BRshreya29/High-Accuracy-Current-Source-for-HVAC-Analog-Control-Applications/ltspice/plots/22_percent_duty_cycle_to_current_precision_output.png

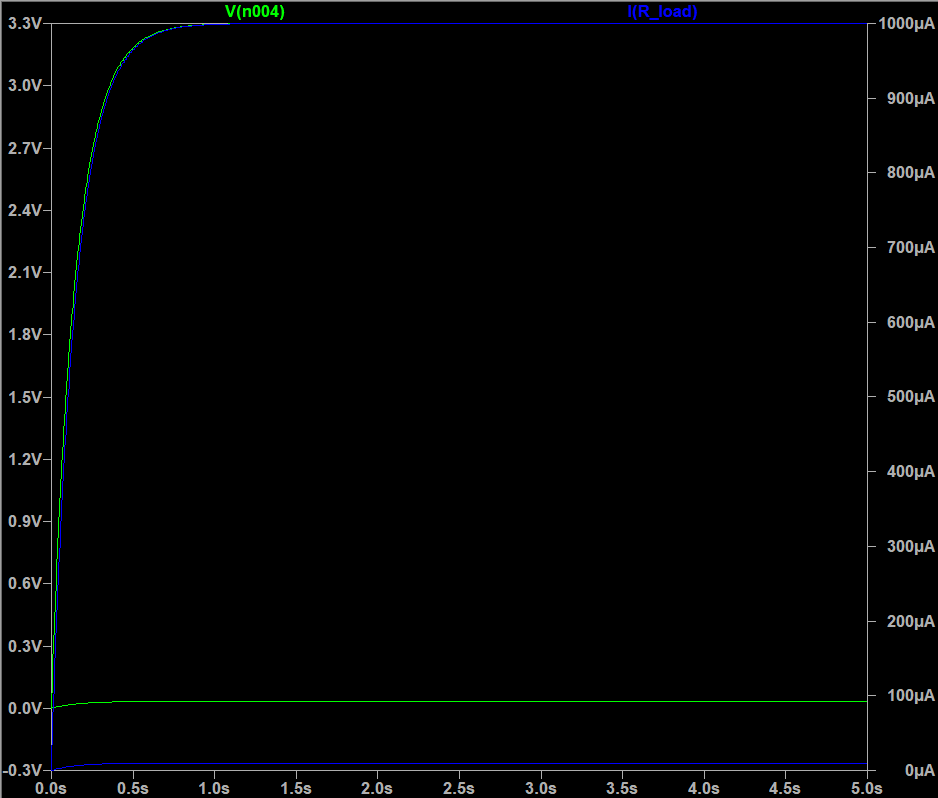
ltspice/plots/22_percent_duty_cycle_to_current_precision_output.png
