BRshreya29/High-Accuracy-Current-Source-for-HVAC-Analog-Control-Applications/ltspice/plots/comparator_0-1mA_output.png

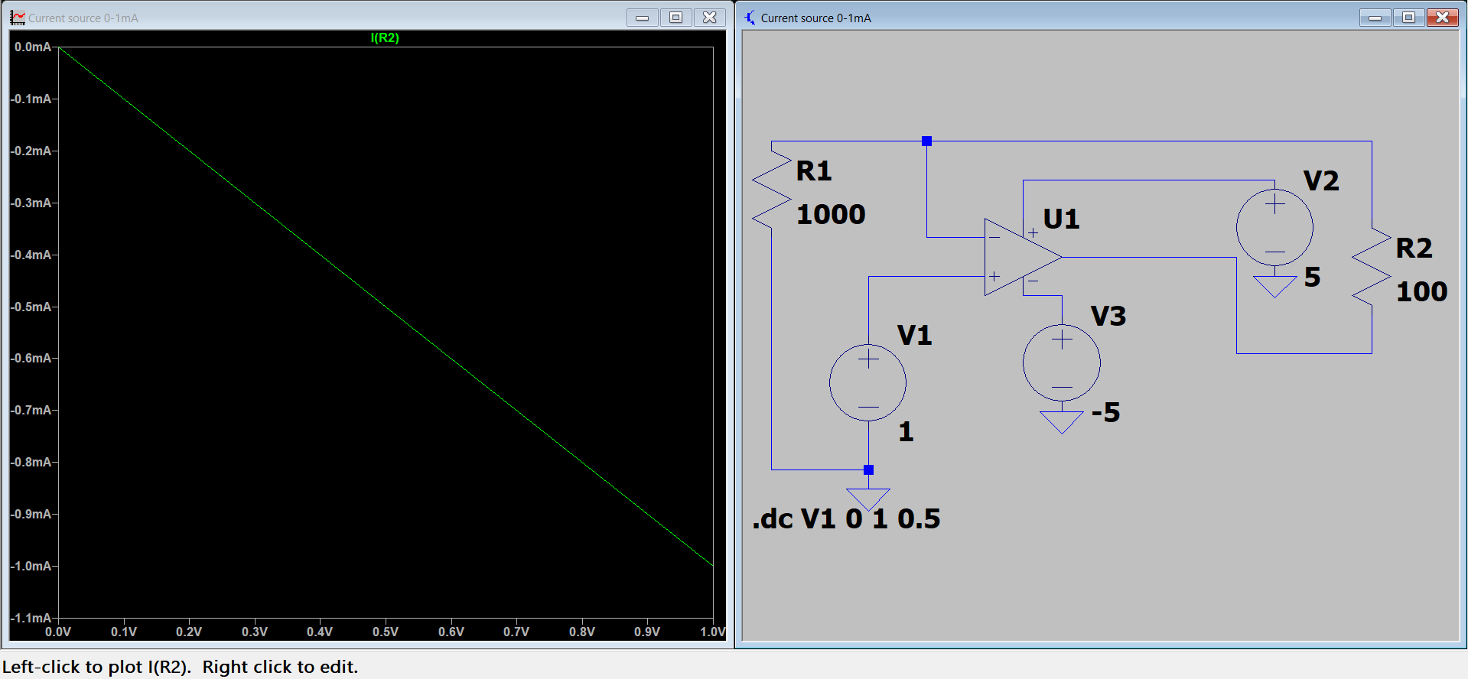
ltspice/plots/comparator_0-1mA_output.png
