BRshreya29/High-Accuracy-Current-Source-for-HVAC-Analog-Control-Applications/ltspice/plots/monte_carlo_analysis.png

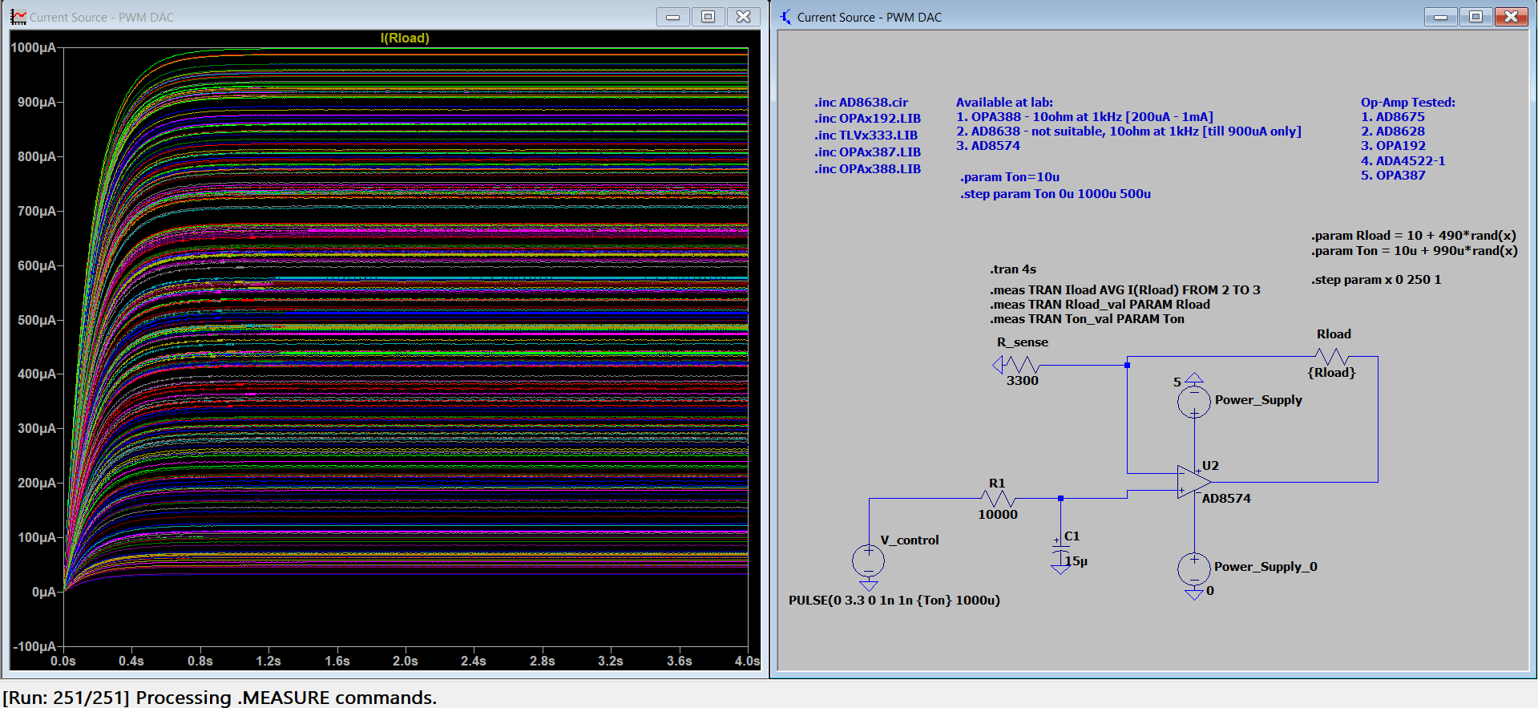
ltspice/plots/monte_carlo_analysis.png
