BRshreya29/High-Accuracy-Current-Source-for-HVAC-Analog-Control-Applications/ltspice/Final_design.asc

C1: polcap; {wc(15µ,tolc,2)}; V=4 Irms=560m Rser=0.2 Lser=0
Power_Supply: voltage; 5
Power_Supply_0: voltage; 0
R1: res; {wc(10000,tolr,1)} tc=0.0001; tol=1
R_sense: res; {wc(3300,tolrsense,0)} tc=0.0001; tol=0.1
Rload: res; 500
U2: AD8574
V_control: voltage; PULSE(0 3.3 0 1n 1n 1000u 1000u)
Named nets: 0
.tran 4s
.param tolr 0.01
.param tolrsense 0.001
.param tolc 0.15
.param numruns 8
.step param run 0 7 1
.meas TRAN V_rload AVG V(N002) - V(N001) FROM 3 TO 4
.meas TRAN Iload AVG I(Rload) FROM 3 TO 4
.meas TRAN R_load_calc PARAM V_rload / Iload
.meas TRAN V_rsense AVG V(n001) FROM 3 TO 4
.meas TRAN I_rsense AVG I(R_sense) FROM 3 TO 4
.meas TRAN R_sense_calc PARAM V_rsense / I_rsense
.temp -40 27 85
.func wc(nom,tol,index) if(run==numruns,nom,if(binary(run,index),nom*(1+tol),nom*(1-tol)))
.func binary(run,index) floor(run/(2**index))-2*floor(run/(2**(index+1)))
Constant Current Source across Rload
Use:
1. wc for Worst Case analysis
2. mc for Monte Carlo analysis
Commands for Measurements:
