BRshreya29/High-Accuracy-Current-Source-for-HVAC-Analog-Control-Applications/ltspice/Testing_stage_file.asc

C1: polcap; 15µ; V=4 Irms=560m Rser=0.2 Lser=0 mfg="Vishay" pn="T55P156M004" type="Tantalum Polymer"
C2: cap; 0.1µ
C3: cap; 2.2µ
Power_Supply: voltage; 5
Power_Supply_0: voltage; 0
R1: res; 10000; tol=5
R2: res; 1k
R3: res; 1k
R4: res; 10k
R_load: res; 500; tol=5
R_sense: res; 3300; tol=1
U1: AD8574
U3: MAX6070_33
U4: AD8031
V1: voltage; 5
V_control: voltage; PULSE(0 1.8 0 5n 5n 1000u 1000u)
Named nets: 0
.tran 3s
.param Ton=10u
.step param Ton 10u 100u 10u
.step param run 0 1 1
Op-Amp Tested:
1. AD8675
2. AD8628
3. OPA192
4. ADA4522-1
5. OPA387
6. MAX4230
7. AD8040
8. OPA4342
.inc OPAx387.LIB
.inc OPAx192.LIB
.func wc(nom,tol,index) if(run==numruns,nom,if(binary(run,index),nom*(1+tol),nom*(1-tol)))
.func binary(run,index) floor(run/(2**index))-2*floor(run/(2**(index+1)))
.param tola 0.05
.meas TRAN V_rsense AVG V(n003) FROM 3 TO 4
.meas TRAN I_rsense AVG I(R_sense) FROM 3 TO 4
.meas TRAN R_sense_calc PARAM V_rsense / I_rsense
.meas TRAN V_rload AVG V(N004) - V(N003) FROM 3 TO 4
.meas TRAN Iload AVG I(R_load) FROM 3 TO 4
.meas TRAN R_load_calc PARAM V_rload / Iload
 
.meas TRAN V_dc AVG V(n007) FROM 3 TO 4
.measure TRAN PulseWidth WHEN V(n010) > 2 RISE=1 FALL=1
.measure TRAN PulseWidthvref WHEN V(n009) > 2 RISE=1 FALL=1
