BRshreya29/High-Accuracy-Current-Source-for-HVAC-Analog-Control-Applications/ltspice/core_comparator_stage.asc

R1: res; 1000
R2: res; 100
U1: UniversalOpAmp
V1: voltage; 1
V2: voltage; 5
V3: voltage; -5
Named nets: 0
.dc V1 0 1 0.5
