BRshreya29/High-Accuracy-Current-Source-for-HVAC-Analog-Control-Applications/test_results/Final_circuit_testing_measurements.xlsx

Sheet: esp
ESP Input |  | DSO Measurements of Input |  |  |  |  | DSO Measurements after V_ref IC |  |  |  |  |  |  | Output |  | Error
 |  |  | Node 1 |  |  |  |  | Node 2 |  |  | Vdc Measurements |  |  | Node 3 | Node 4 | Absoulte Error | Percentage Error | Absoulte Error | Percentage Error
DutyCycle_Input(%) | CH1_Amplitude(V) | CH1_Freq(Hz) | CH1_PosWidth(µs) | CH1_Period(µs) | CH1_DutyCycle(%) | CH1_Amplitude(V) | CH1_Freq(Hz) | CH1_PosWidth(s) | CH1_Period(s) | CH1_DutyCycle(%) | VDC_expected (V) | Vdc_error | Vdc_expected for 3.24 V | VDC_DMM(V) | IDC_DMM(µA) | Idc (µA) | Idc | Vdc (A) | Vdc
1 | 3.68 | 1000.21 | 10.64 | 999.79 | 1.06 | 3.43 | 1000.17 | 10.71 | 999.83 | 1.07 | 0.03 | 0.01 | 0.03242 | 0.043663 | 13.26 | 2.55 | 19.23 | 0.011 | 32.31
2 | 3.58 | 1000.25 | 20.73 | 999.75 | 2.07 | 3.43 | 1000.26 | 20.77 | 999.74 | 2.08 | 0.07 | 0.01 | 0.06482 | 0.076517 | 23.22 | 2.45 | 10.56 | 0.011 | 15.93
3 | 3.90 | 1000.21 | 30.82 | 999.79 | 3.08 | 3.43 | 1000.19 | 30.68 | 999.81 | 3.07 | 0.10 | 0.01 | 0.09722 | 0.109430 | 33.20 | 2.53 | 7.61 | 0.010 | 10.54
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
