BRshreya29/High-Accuracy-Current-Source-for-HVAC-Analog-Control-Applications/test_results/Monte-Carlo_Analysis.xlsx

Sheet: Step 4
Step Number | Ton | R_load | I_load (A) | I_load (µA )
0 | 0.000505 | 255 | 0.000505 | 505
1 | 0.000318694 | 162.788 | 0.000318699 | 318.699
2 | 0.000518204 | 261.535 | 0.000518204 | 518.204
3 | 0.000240247 | 123.961 | 0.000240253 | 240.253
4 | 0.00084715 | 424.347 | 0.000847143 | 847.143
5 | 0.000165591 | 87.0095 | 0.000165598 | 165.598
6 | 0.000421355 | 213.6 | 0.000421357 | 421.357
7 | 6.98416e-05 | 39.6186 | 6.98502e-05 | 69.8502
8 | 0.000168517 | 88.4581 | 0.000168524 | 168.524
9 | 0.000675399 | 339.339 | 0.000675396 | 675.396
10 | 0.000263446 | 135.443 | 0.000263451 | 263.451
11 | 0.000845394 | 423.478 | 0.000845387 | 845.387
12 | 0.000338679 | 172.68 | 0.000338683 | 338.683
13 | 0.000677072 | 340.167 | 0.000677069 | 677.069
14 | 0.000192905 | 100.529 | 0.000192912 | 192.912
15 | 0.000112209 | 60.5884 | 0.000112217 | 112.217
16 | 0.000255889 | 131.703 | 0.000255895 | 255.895
17 | 0.000770869 | 386.592 | 0.000770864 | 770.864
18 | 0.000573059 | 288.686 | 0.000573058 | 573.058
19 | 0.000786578 | 394.367 | 0.000786573 | 786.573
20 | 0.000622708 | 313.26 | 0.000622707 | 622.707
21 | 0.00013969 | 74.19 | 0.000139697 | 139.697
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
