BRshreya29/High-Accuracy-Current-Source-for-HVAC-Analog-Control-Applications/test_results/Worst_Case_Analysis.xlsx

Sheet: Rsense tol 0.1% tc 100ppm
Step Number | Temperature (°C) | R_sense (Ω) | Duty Cycle, I_load Expected (%, µA) | I_load (A) | I_load (µA)
1 | -40 | 3274.61 | 1, 10 | 0.0000100799 | 10.0799
2 | -40 | 3281.17 | 1, 10 | 0.0000100597 | 10.0597
3 | -40 | 3274.61 | 1, 10 | 0.0000100798 | 10.0798
4 | -40 | 3281.17 | 1, 10 | 0.0000100596 | 10.0596
5 | -40 | 3274.61 | 1, 10 | 0.0000100799 | 10.0799
6 | -40 | 3281.17 | 1, 10 | 0.0000100597 | 10.0597
7 | -40 | 3274.61 | 1, 10 | 0.0000100803 | 10.0803
8 | -40 | 3281.17 | 1, 10 | 0.0000100597 | 10.0597
9 | 27 | 3296.7 | 1, 10 | 0.0000100111 | 10.0111
10 | 27 | 3303.3 | 1, 10 | 0.0000099914 | 9.99137
11 | 27 | 3296.7 | 1, 10 | 0.0000100181 | 10.0181
12 | 27 | 3303.3 | 1, 10 | 0.0000099981 | 9.99811
13 | 27 | 3296.7 | 1, 10 | 0.0000100110 | 10.011
14 | 27 | 3303.3 | 1, 10 | 0.0000099910 | 9.99098
15 | 27 | 3296.7 | 1, 10 | 0.0000100187 | 10.0187
16 | 27 | 3303.3 | 1, 10 | 0.0000099987 | 9.99868
17 | 85 | 3315.82 | 1, 10 | 0.0000099600 | 9.96003
18 | 85 | 3322.46 | 1, 10 | 0.0000099401 | 9.94014
19 | 85 | 3315.82 | 1, 10 | 0.0000099599 | 9.9599
20 | 85 | 3322.46 | 1, 10 | 0.0000099400 | 9.94001
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
